TheAsaf/RISC-V-SoC-Sky130/docs/images/cpu_bus_waveform.png

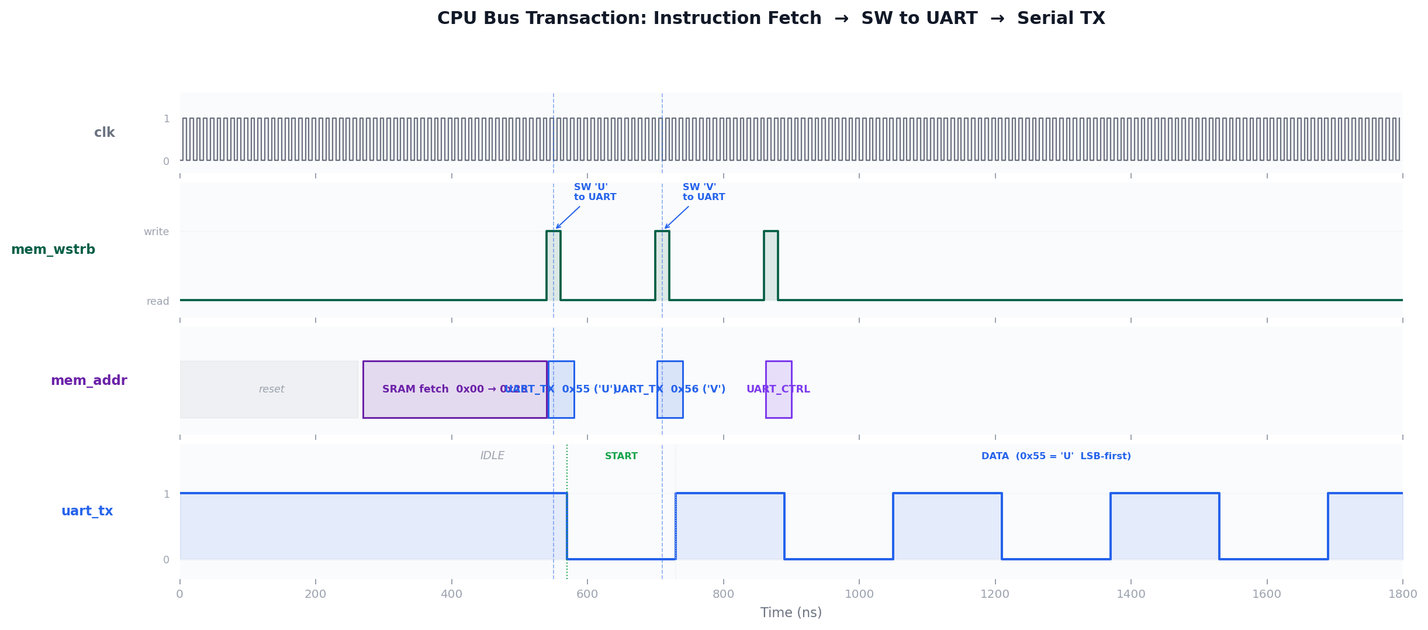
docs/images/cpu_bus_waveform.png
