TheAsaf/RISC-V-SoC-Sky130/(commit log)

2026-04-02 feat: add PicoRV32 RV32I SoC with UART interrupt, firmware, and full documentation
    Evolves the UART IP into a complete SoC:
    - RTL: soc_top, soc_bus, soc_sram integrating PicoRV32 + UART peripheral
    - Firmware: RV32I assembly startup, C driver, Python encoder (no toolchain required)
    - Testbench: system-level soc_top_tb with 4 passing tests (CPU boot, UART TX, IRQ assert/clear)
    - Physical: OpenLane config, SDC, and pin order for sky130 tapeout
    - Docs: complete README + sub-READMEs covering architecture, bugs, design decisions
    All 10 tests pass (6 UART unit + 4 SoC system).
    [pin_order.cfg]
2026-04-02 docs: replace text diagrams with visual assets, rewrite README
    - New README: 243 lines, fully visual, no ASCII diagrams
    - soc_architecture.png: full SoC block diagram (matplotlib)
    - cpu_bus_waveform.png: CPU fetch → SW to UART → serial TX
    - interrupt_flow.png: RX byte → irq assert → ISR → irq clear
    - gen_soc_visuals.py: generation script for all three PNGs
    - Register map and architecture SVGs regenerated
    [gen_soc_visuals.py]
2026-04-03 docs: restructure README as polished engineering portfolio
    - Architecture diagram is now the hero (first thing after tagline)
    - Replace "What Is This Project?" prose with "What makes this interesting" — 3 concrete bullets
    - Add "three data paths" table: what hardware each path uses and how it's verified
    - Side-by-side HTML table for UART 8N1 + FIFO burst waveforms (saves vertical space)
    - Verification section: side-by-side test tables with ✅, prominent persistent-monitor insight
    - Physical design: results summary table (cells, area, flow) below the GDS image
    - Design decisions and bugs as tight tables — scannable in seconds
    - Repository tree compressed to one line per directory
    Co-Aut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
2026-04-03 docs: redesign architecture diagram and add plain-language project summary
    Architecture diagram:
    - New block() helper auto-centres text vertically with proportional spacing
    - Canvas enlarged to 20x12 inches; blocks enlarged proportionally
    - All font sizes raised: block titles 14-18pt, body text 10.5-12pt minimum
    - Strict horizontal/vertical alignment: soc_bus, reg interface, and uart_rx
    all share the same vertical axis (x=7.6) for clean straight arrows
    - Removed small-font bus-signal annotation that cluttered the arrow area
    - Single-line combined subtitle for uart_rx ("2-FF sync · mid-bit sample")
    README:
    - New "What we built" section (5 lines, no jargon) placed after the
    architecture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
    [gen_soc_visuals.py]
